TudorBld/Cable-continuity-tester/README.md

# Cable-continuity-tester
A cable tester for multiple wire cables.

### Scope
This project provides code and instructions for building a general porpouse multi-wire cable tester.\
It uses an Arduino mega in order to satify the potentially high number of wires in a cable.

### Project requirements
- Test for 0, X, Y and short-circuit type errors*
- Programable wire template
- Save the wire template.
- LED indication of errors
- LCD display for detailed explanation of errors
- Different testing modes:
- Accept a golden standard cable template
- Be able to accept the new template without reprogramming the arduino.
  - Fast: tests all connetctions at high speed and shows a list of errors
  - Stop on error: if current wire is OK, jumpes to the next. Otherwise waits for user input.
  - Read and Save Golden Sample

\
\*\
0 = no continuity\
X = wire mismatch\
Y = 1 input has multiple outputs\
short-circuit = input loops back to another input

### Algorithm
Using the cable template, the arduino will go trough the cable input wires.
5 volts are applied to the input wire. The arduino checks all other wires for signal.
It than determines if the signal is detected on correct wires, otherwise finds the type of error.
After this process, voltage is no longer applied to the currect pin and the arduino continues to the next input pin.
