TudorBld/Cable-continuity-tester/Documentation/Pictures_and_source_files/Connections.pdf

VEDERE DE SUS (DINSPRE BUTOANE)

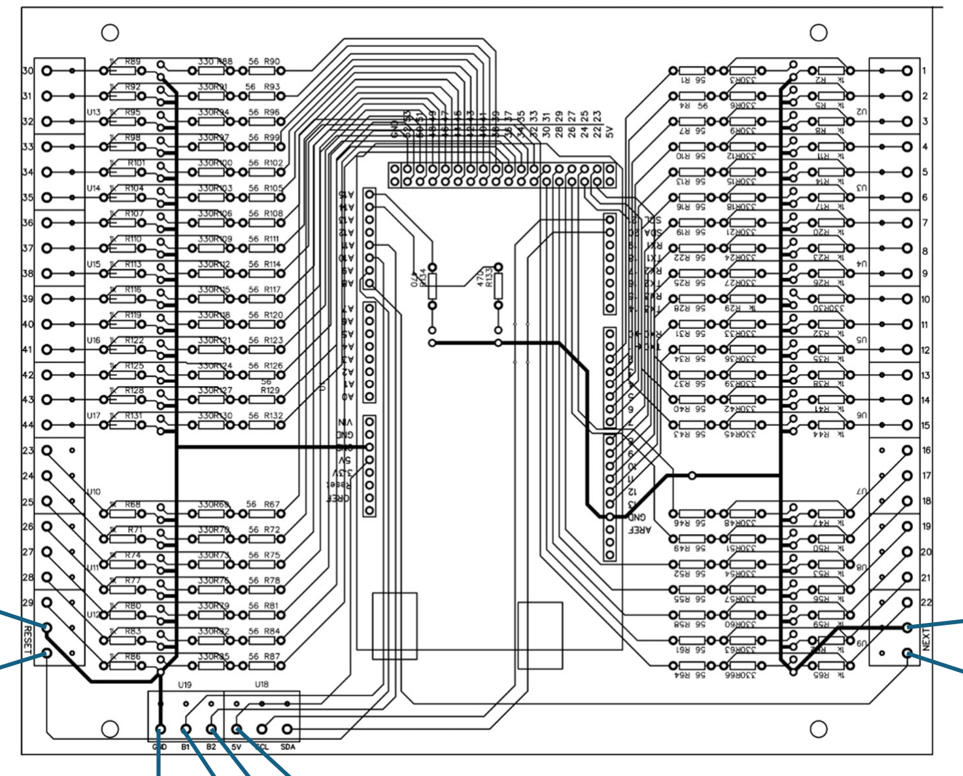
[picture p1: figure]

Buton OK
NC

Buton NEXT
NO

Buton MENU
NO
