TudorBld/Cable-continuity-tester/(commit log)

2022-05-02 Add cable template format description and arduino code file
2022-05-02 Change wire numbering in cable template format
2022-05-02 Write some code
    Create a cable structure whitch holds wire connection info
    Create an error structure whitch holds chech results
    Create a chech_pin function whitch checks an input pin for output errors and returns a report in thr form of a err variable
2022-05-05 Reformulate and elaborate the cable-template-format description
2022-05-16 Change values for testing the pcb
2022-05-23 Implement master_good/error leds, with brightness controll
2022-05-24 Change hardware pin order, make a function for serial output
2022-05-27 Implement reset button
2022-11-08 Move Arduino nano code to main folder
2022-11-08 Improve User Interface (buttons and serial)
    Change mode on reset, not only on startup
    Move "State.mode = 0" from loop to setup
    Fix current mode not showing up on selecting menu if cirrent mode is different from fast mode
    Show errors on screen in "stop on error mode"
    Begin making serial commands work averywhere
2022-12-10 Change led scroll speed via potentiometer in menu
2023-02-25 Implement Golden Sample template save
2023-04-05 Implement Golden sample V2 and tweek menu
2025-11-29 Fix bug where sending 's' did not work. Make reset work from command
    [Cable_Tester_code.ino]
2025-11-29 Change max number of errors and max number of wires in a net
    [Cable_Tester_code.ino]
2025-11-29 Prepare code for saving cable template in EEPROM
2025-12-02 Save GS in EEPROM. Fix GS net read from 5 to macro
    [Cable_Tester_code.ino, Macros.h]
2025-12-02 Change check from all wires to input wires to allow any cable config
2025-12-06 Add function GSR_V3, which saves all wire loops, not just roots Ghange ii to i in primary loops
2025-12-06 Change algorithm for iterating wires to all wires, not just roots Change delay time after shutting down pin to 100 us from 1 ms
2025-12-06 Remove short circuit errors from Check_pin function Update documentation in Core_structs.h to deprecate short circuits Indent documentation in Core_Structs.h cable structure
    [Cable_Tester_code.ino, Core_structs.h]
2025-12-06 Adapt macro numbers for max pins and errors. Add guards for when too many errors appear
    [Cable_Tester_code.ino, Data_manipulation_functions.cpp, Macros.h]
2025-12-13 Multiple bugs fixed Change pin order and led speed animation pins Add serial menu status after GS save Change serial menu display text Change k from 44 to MAX_ROOTS in switch Fix bug where most r sen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
    [Cable_Tester_code.ino]
2025-12-13 Change code for buttons OK and NEXT to NC
